TheWavetableProject/wavetable_pico/materials/wiring_diagram@2160x.png

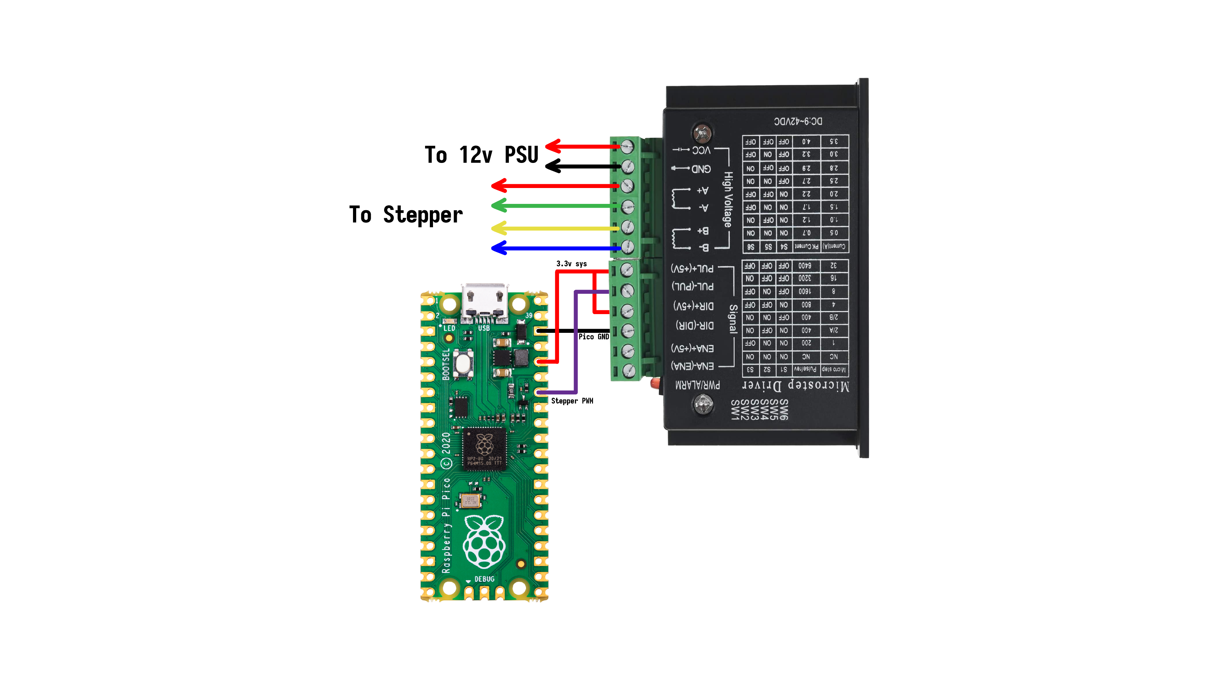
materials/wiring_diagram@2160x.png
