TheWavetableProject/wavetable_pico/(commit log)

2021-04-03 doesn't compile with stdio??
    [main.c]
2021-05-07 belt ratio was implicitly zero
2021-05-10 UT snap: basic sine impl
    [main.c]
2021-05-25 wiring diagram
2021-06-02 wiring docs updates
2021-06-03 wiring documentation improvements
2021-06-04 don't reflect pico in wiring diagram
2021-09-01 basic arduino sketch
2022-01-24 fix link to dip switches image
2022-04-05 add bearing sticking troubleshooting tips
